uio-ess/bi_dump_chamber/drawings/switch positions - 20895 sketch.pdf

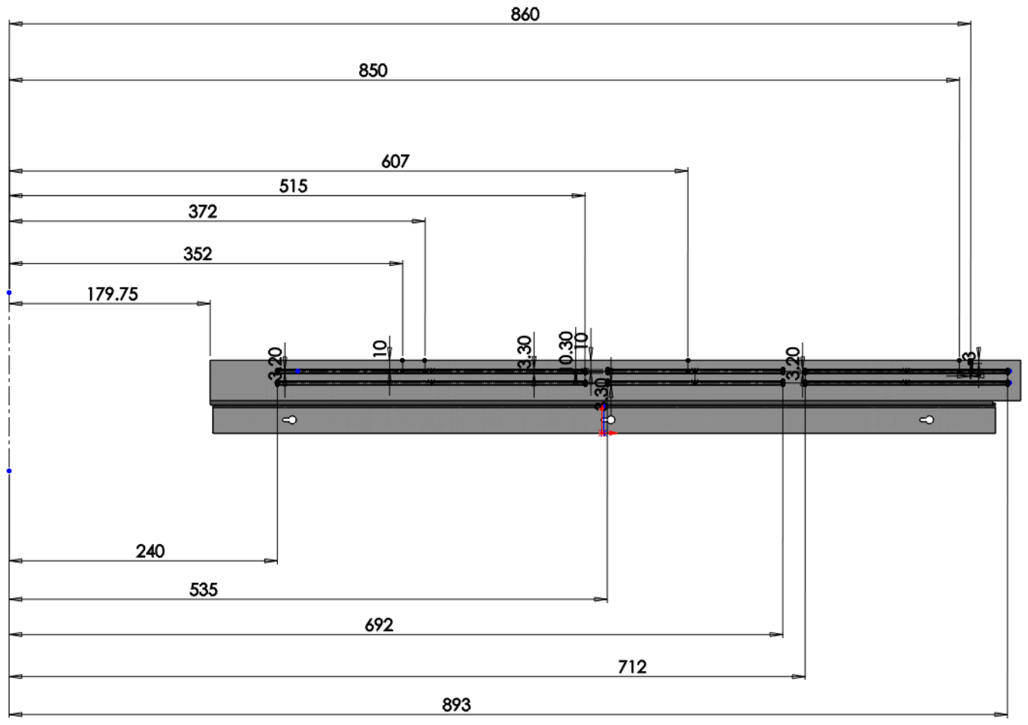
[picture p1: page 1]
