uio-ess/bi_dump_chamber/mirror_mounts/Screenshot from 2020-08-27 12-47-55.png

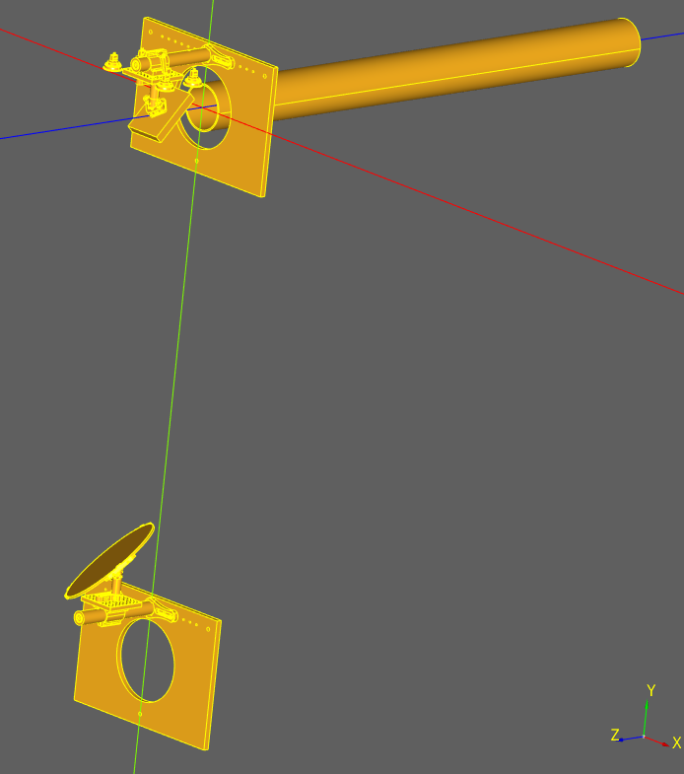
mirror_mounts/Screenshot from 2020-08-27 12-47-55.png
