uio-ess/bi_dump_chamber/screen_holder_assembly/step_output/assembly.step

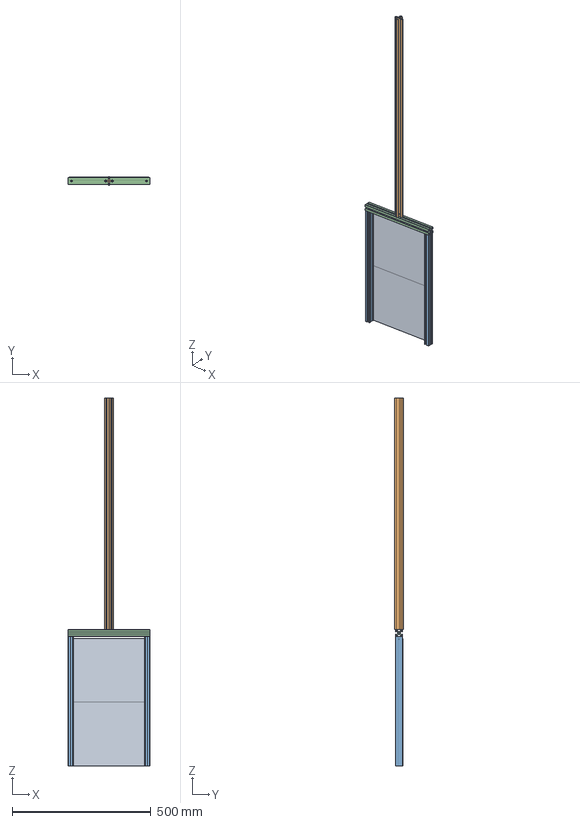
[picture p3: CAD file, 2020-08-26]
screen_holder_assembly/step_output/assembly.step
295.0 x 33.9 x 1327.0 mm
