uio-ess/bi_dump_chamber/mirror_mounts/Mirror_Assembly_M9_B.stp

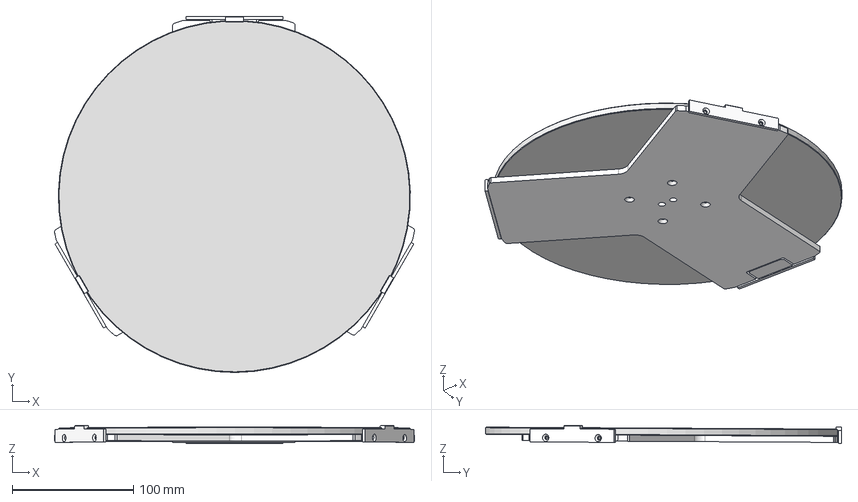
[picture p4: CAD file, 2020-08-27]
mirror_mounts/Mirror_Assembly_M9_B.stp
296.7 x 293.3 x 15.0 mm
Adaptor_Back_Plate_M9_ConceptB
Clamp_M9_C
Dowel_pin003 x 4
Mirror_OD290_t6mm
Clamp_M9_C_low001 x 2
