uio-ess/bi_dump_chamber/mirror_mounts/BA1L_M-Step.step

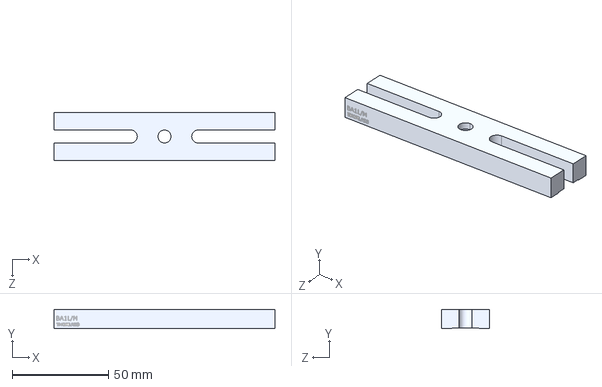
[picture p5: CAD file, 2020-08-28]
mirror_mounts/BA1L_M-Step.step
115.0 x 10.0 x 25.0 mm
