uio-ess/bi_dump_chamber/mirror_mounts/output/pipe.step

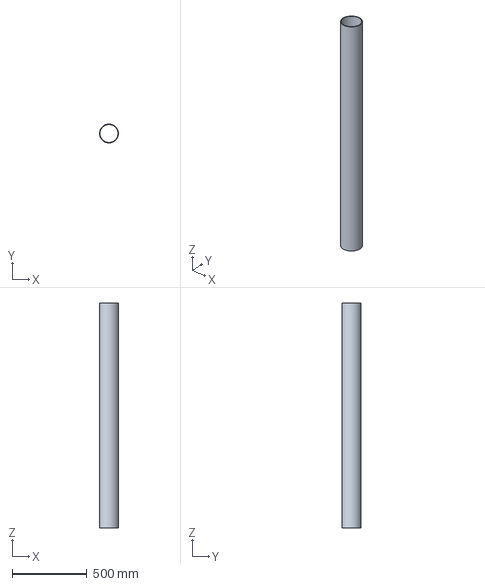
[picture p6: CAD file, 2020-08-28]
mirror_mounts/output/pipe.step
126.9 x 126.9 x 1500.0 mm
