uio-ess/bi_dump_chamber/screen_holder_assembly/step_input/XE25RL2-Step.step

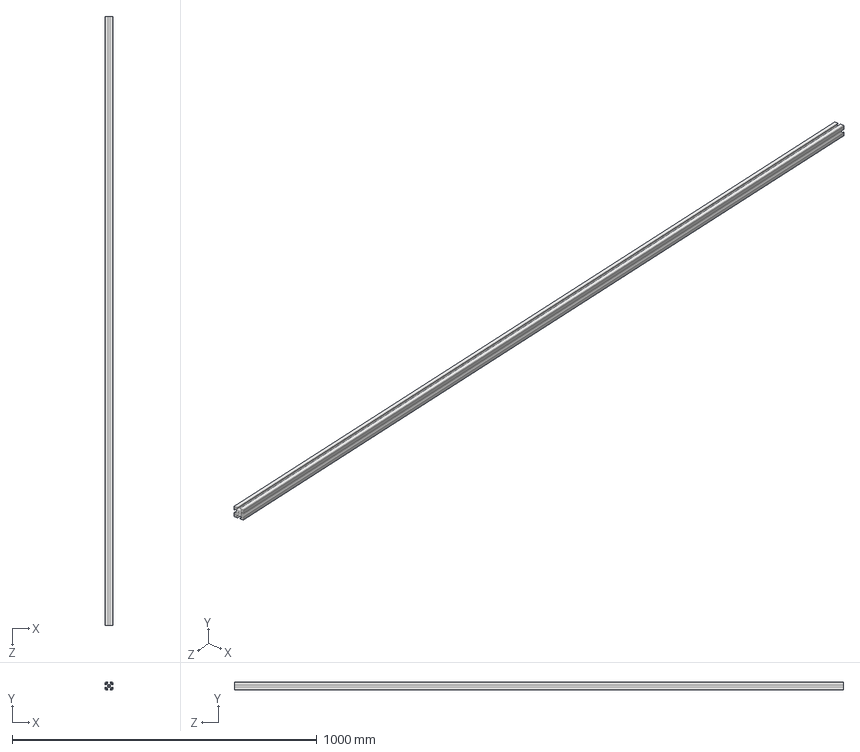
[picture p7: CAD file, 2020-08-26]
screen_holder_assembly/step_input/XE25RL2-Step.step
25.0 x 25.0 x 2000.0 mm
