uio-ess/bi_dump_chamber/frame_holder_piece.step

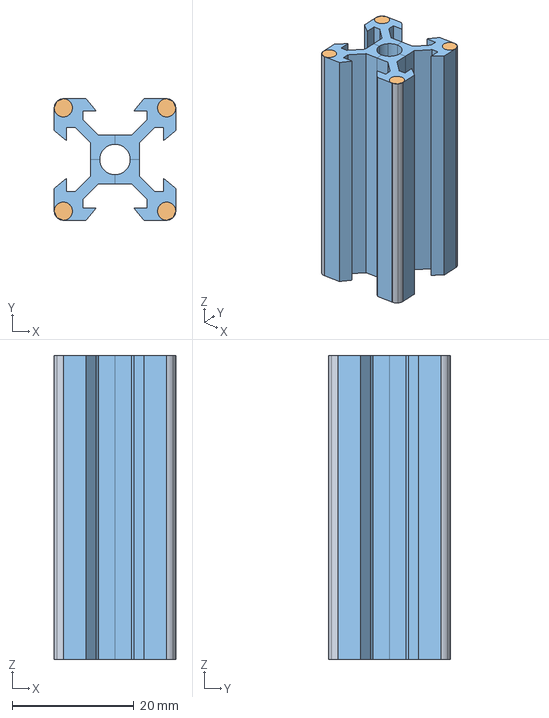
[picture p8: CAD file, 2018-11-07]
frame_holder_piece.step
20.0 x 20.0 x 50.0 mm
