uio-ess/bi_dump_chamber/mirror_mounts/plate_layout.dxf

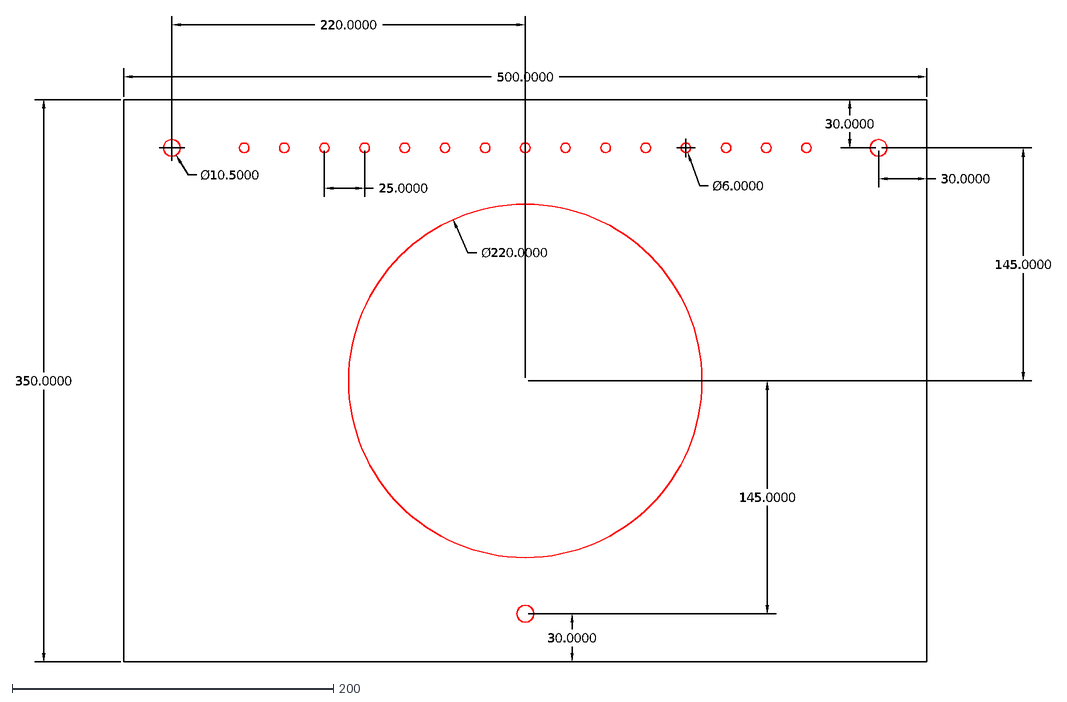
[picture p9: CAD file, 2020-08-27]
mirror_mounts/plate_layout.dxf
350.0000
500.0000
Ø10.5000
Ø220.0000
30.0000
25.0000
Ø6.0000
145.0000
220.0000
