uio-ess/bi_dump_chamber/screen_holder_assembly/step_output/frame_and_screens.step

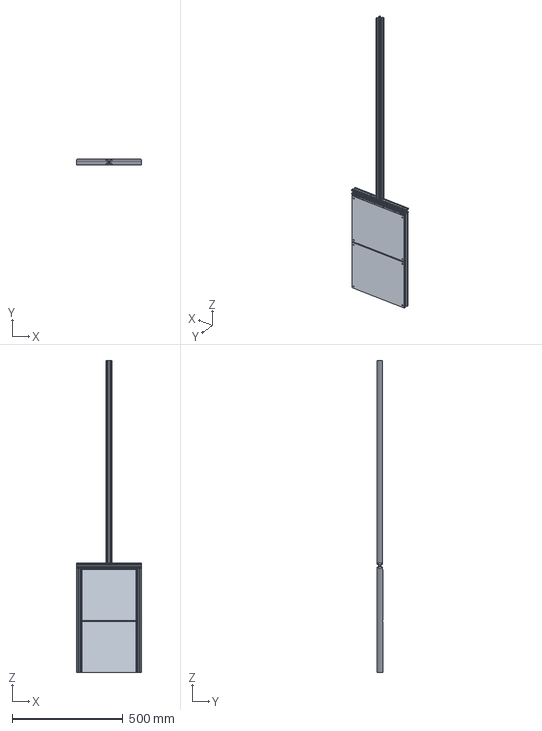
[picture p10: CAD file, 2019-09-20]
screen_holder_assembly/step_output/frame_and_screens.step
295.0 x 26.5 x 1410.0 mm
