uio-ess/bi_dump_chamber/chromux_screens.dxf

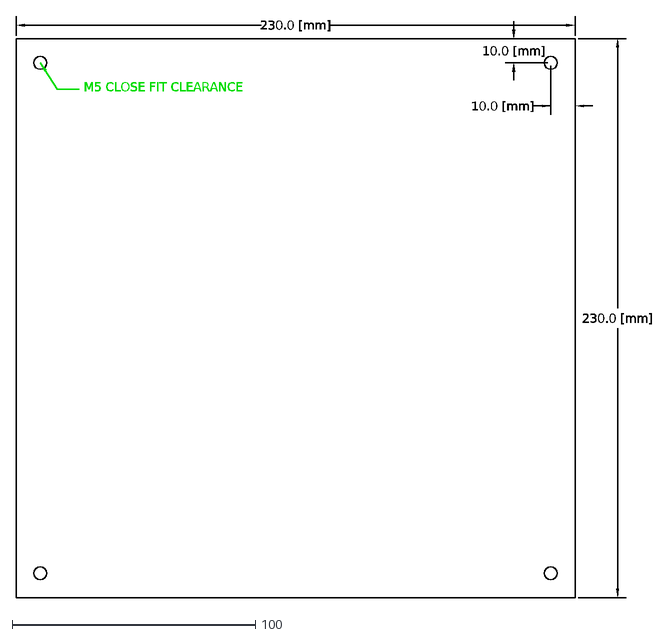
[picture p11: CAD file, 2018-10-30]
chromux_screens.dxf
M5 CLOSE FIT CLEARANCE
230.0 [mm]
10.0 [mm]
