uio-ess/bi_dump_chamber/drawings/bar_cuts_B.dxf

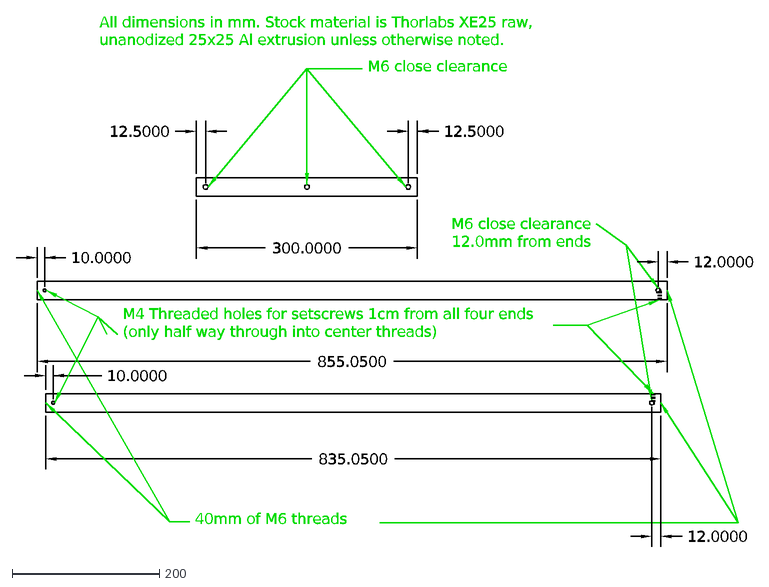
[picture p12: CAD file, 2019-10-22]
drawings/bar_cuts_B.dxf
835.0500
855.0500
300.0000
12.5000
40mm of M6 threads
M6 close clearance
M6 close clearance 12.0mm from ends
10.0000
M4 Threaded holes for setscrews 1cm from all four ends (only half way through into center threads)
12.0000
All dimensions in mm. Stock material is Thorlabs XE25 raw, unanodized 25x25 Al extrusion unless otherwise noted.
