uio-ess/bi_dump_chamber/mirror_mounts/P250_M-Step.step

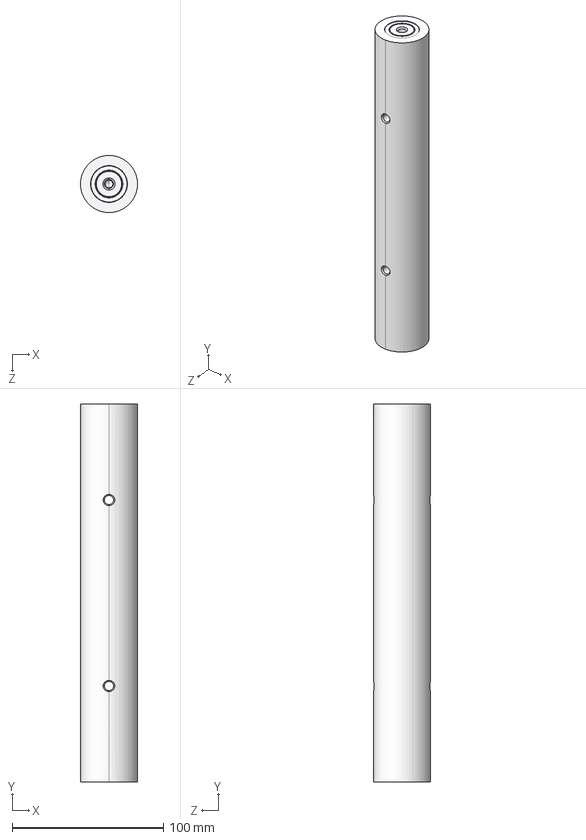
[picture p13: CAD file, 2020-08-27]
mirror_mounts/P250_M-Step.step
37.7 x 250.0 x 37.7 mm
