uio-ess/bi_dump_chamber/drawings/plates.dxf

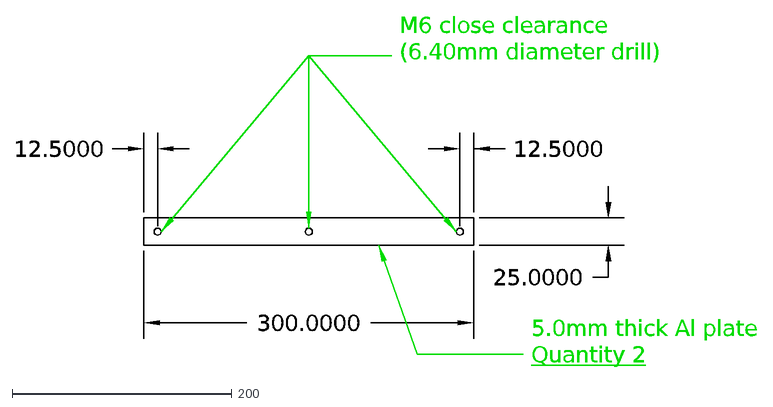
[picture p14: CAD file, 2019-10-11]
drawings/plates.dxf
300.0000
12.5000
M6 close clearance (6.40mm diameter drill)
5.0mm thick Al plate Quantity 2
25.0000
