uio-ess/bi_dump_chamber/mirror_mounts/P75_M-Step.step

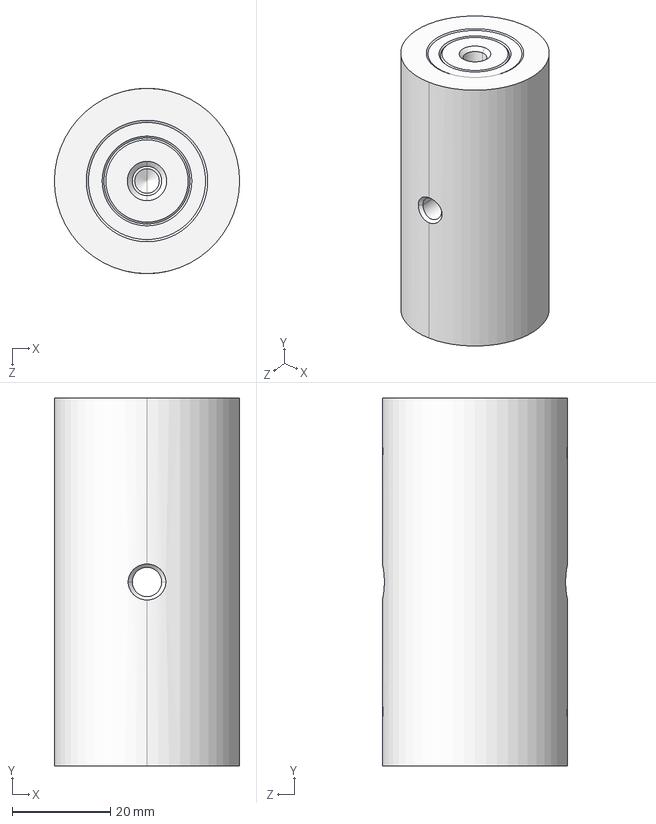
[picture p15: CAD file, 2020-08-27]
mirror_mounts/P75_M-Step.step
37.7 x 75.0 x 37.7 mm
