uio-ess/bi_dump_chamber/mirror_mounts/POLARIS-CA25_M-Step.step

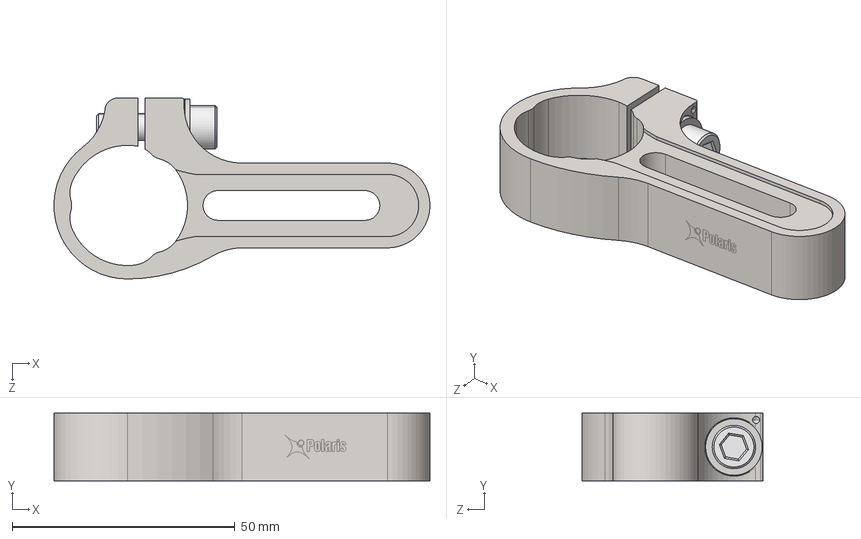
[picture p16: CAD file, 2020-08-27]
mirror_mounts/POLARIS-CA25_M-Step.step
84.4 x 15.2 x 40.6 mm
