uio-ess/bi_dump_chamber/mirror_mounts/C1545_M-Step.step

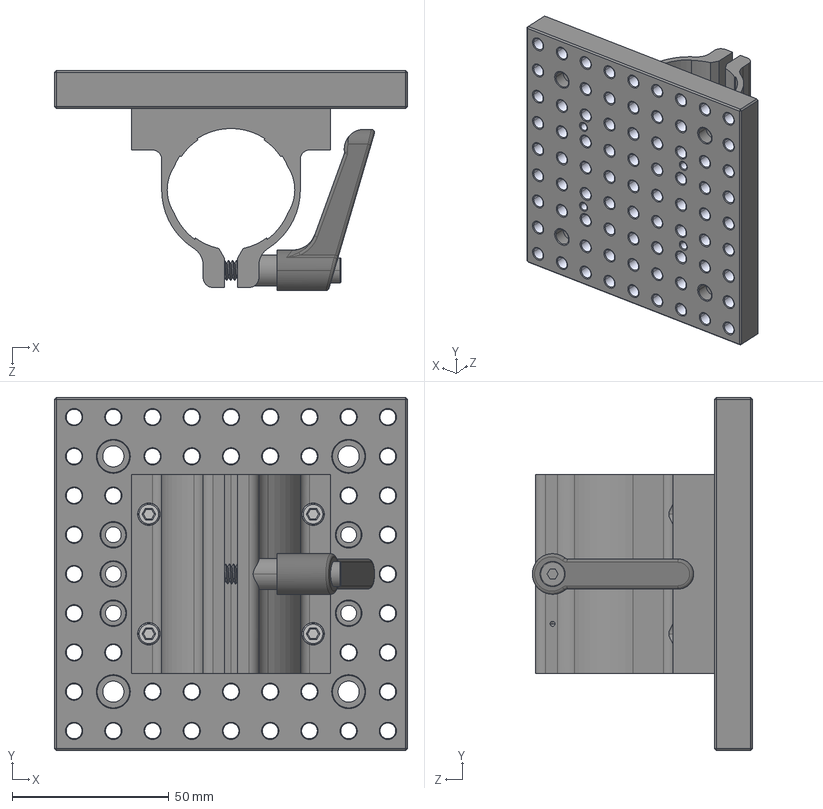
[picture p17: CAD file, 2020-08-27]
mirror_mounts/C1545_M-Step.step
112.5 x 112.5 x 70.2 mm
