uio-ess/bi_dump_chamber/mirror_mounts/P200_M-Step.step

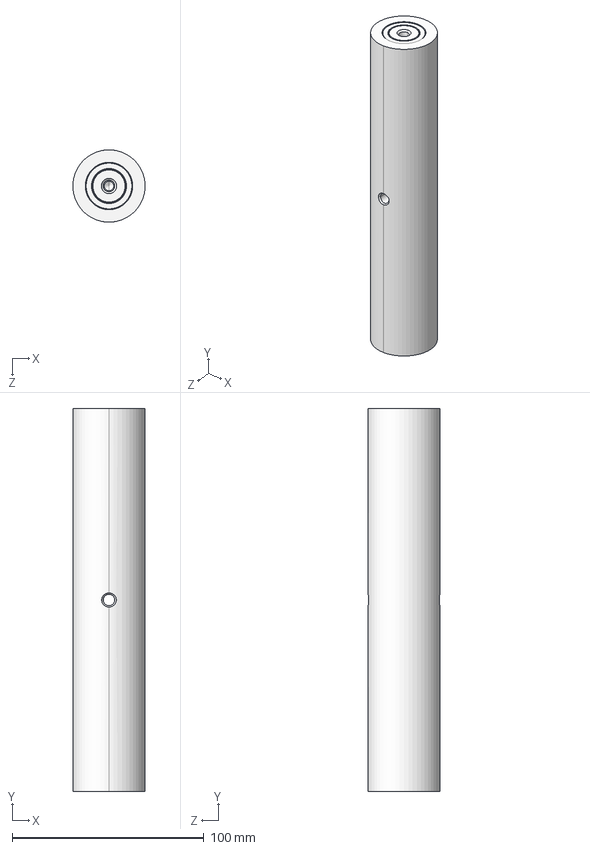
[picture p18: CAD file, 2020-08-26]
mirror_mounts/P200_M-Step.step
37.7 x 200.0 x 37.7 mm
