uio-ess/bi_dump_chamber/mirror_mounts/POLARIS-MA45_M-Step.step

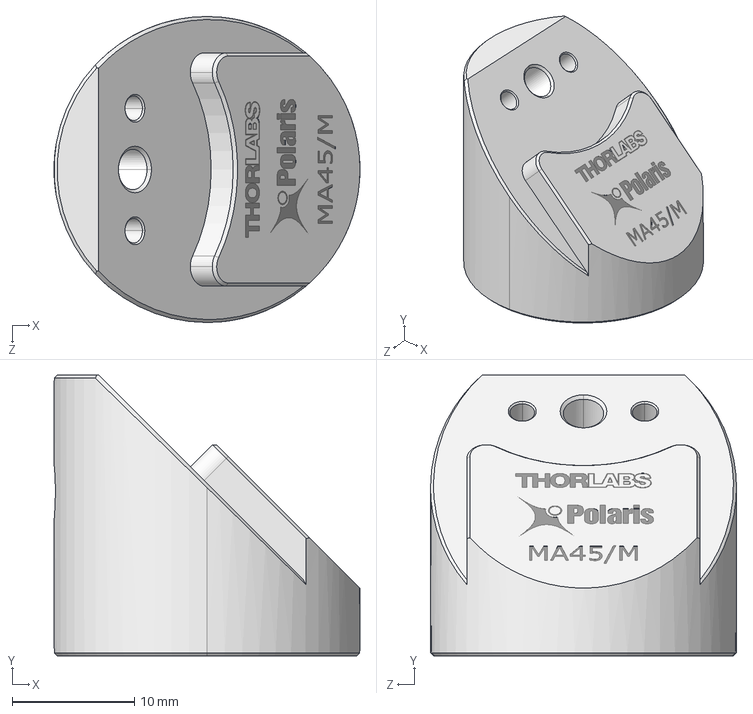
[picture p19: CAD file, 2020-08-26]
mirror_mounts/POLARIS-MA45_M-Step.step
25.0 x 22.9 x 25.0 mm
