uio-ess/bi_dump_chamber/screen_holder_assembly/assembly.scad

// written by grey@christoforo.net

include <al_strut.scad>
//include <threads.scad>

// all dims in mm

screenX = 290;
screenY = 230;
screenT = 1.5;

pipe_inner_diameter = 250;

view_ellipse_Z = 220;
view_ellipse_XY = 306;

spacing_between_screens = 0;

top_bar_spacing = 7;

strut_square = 25;

long_rod_length = 835.05;

draw_threads = false;

//crossbar_width = screenX-2*strut_square;
crossbar_width = 300; // the 5 here is to ensure screen mounting hole alignment
//crossbar_width = screenX-2*strut_square-10-10-25;
echo(crossbar_width);

sidebar_length = spacing_between_screens + 2*screenY + top_bar_spacing;
echo(sidebar_length);

length_of_framing = sidebar_length*2+crossbar_width+long_rod_length;
echo(length_of_framing=length_of_framing);

screen_mount_hole_diameter = 5.8;

//screen_mount_hole_offset = strut_square/2;
screen_mount_hole_offset = 10;

//3cm of m5 threads
//5cm of smooth
// 6cm piece with vent hole at 2cm
module mount_piece(){
    length = 60;
    offset = 30;
    difference(){
        translate([0,0,-offset]) metric_thread (diameter=5, pitch=0.8, length=length);
        cylinder(h=offset,d=2);
        rotate([90,0,0]) cylinder(h=offset,d=2);

    }
}


module view_ellipse(){
        //color([0,1,0]) translate([screenX/2, screenT, screenY/2]) rotate([90, 0 ,0]) scale([view_ellipse_XY, view_ellipse_Z]) circle(d=1);
}

module pipe_view_circle(){
        //#color([0,0,1]) translate([screenX/2, screenT*2, screenY/2]) rotate([90, 0 ,0]) scale([pipe_inner_diameter, pipe_inner_diameter]) circle(d=1);
}

// draws the whole assembly
module assembly(){
    // long "shaft" bar
    rotate([0,0,45]) extrusion_profile_20x20_v_slot_smooth(size=strut_square, height=long_rod_length);
    
    //cross bar
    translate([-crossbar_width/2,0,-strut_square/2]) rotate([0,90,0]) extrusion_profile_20x20_v_slot_smooth(size=strut_square, height=crossbar_width);
    
    //sidebars
    translate([crossbar_width/2-strut_square/2,0,-sidebar_length-strut_square]) extrusion_profile_20x20_v_slot_smooth(size=strut_square, height=sidebar_length);
    translate([-crossbar_width/2+strut_square/2,0,-sidebar_length-strut_square]) extrusion_profile_20x20_v_slot_smooth(size=strut_square, height=sidebar_length);
    
    //%translate([-crossbar_width/2,0,-sidebar_length+strut_square/2]) rotate([0,90,0]) extrusion_profile_20x20_v_slot_smooth(size=strut_square, height=crossbar_width);
    
    //screen1
    translate([-screenX/2,strut_square/2,-screenY-strut_square-top_bar_spacing]){
        //translate ([0,0,-0]) view_ellipse();
        //translate ([0,0,-0]) pipe_view_circle();
        #color([1,1,1]) difference(){
            cube([screenX, screenT, screenY], center=false);
            rotate([90,0,0]) translate ([screen_mount_hole_offset,screen_mount_hole_offset,0]) cylinder(h=screenT*2.2, d=screen_mount_hole_diameter, center=true);
            rotate([90,0,0]) translate ([screenX-screen_mount_hole_offset,screen_mount_hole_offset,0]) cylinder(h=screenT*2.2, d=screen_mount_hole_diameter, center=true);
            rotate([90,0,0]) translate ([screenX-screen_mount_hole_offset,screenY-screen_mount_hole_offset,0]) cylinder(h=screenT*2.2, d=screen_mount_hole_diameter, center=true);
            rotate([90,0,0]) translate ([screen_mount_hole_offset,screenY-screen_mount_hole_offset,0]) cylinder(h=screenT*2.2, d=screen_mount_hole_diameter, center=true);
        }
    }
    
    //screen 2
    translate([-screenX/2,strut_square/2,-2*screenY-strut_square-spacing_between_screens-top_bar_spacing]){
        //view_ellipse();
        //pipe_view_circle();
        #color([1,1,1]) difference(){
            cube([screenX, screenT,screenY], center=false);
            rotate([90,0,0]) translate ([screen_mount_hole_offset,screen_mount_hole_offset,0]) cylinder(h=screenT*2.2, d=screen_mount_hole_diameter, center=true);
            rotate([90,0,0]) translate ([screenX-screen_mount_hole_offset,screen_mount_hole_offset,0]) cylinder(h=screenT*2.2, d=screen_mount_hole_diameter, center=true);
            rotate([90,0,0]) translate ([screenX-screen_mount_hole_offset,screenY-screen_mount_hole_offset,0]) cylinder(h=screenT*2.2, d=screen_mount_hole_diameter, center=true);
            rotate([90,0,0]) translate ([screen_mount_hole_offset,screenY-screen_mount_hole_offset,0]) cylinder(h=screenT*2.2, d=screen_mount_hole_diameter, center=true);
        }
    }
    
    // threaded mount
    if (draw_threads){
        translate([0,0,long_rod_length]) mount_piece();
    }
}

//assembly();
