uio-ess/bi_dump_chamber/screen_holder_assembly/main.scad

include <assembly.scad>

assembly();
