uio-ess/bi_dump_chamber/simple_mockup/main.scad

include <chamber_mockup.scad>

// downstream chamber
drawChamber();

//translate ([-600,0,0]) translate ([400,0,0]) drawChamber(); 

//translate ([-1500,0,0]) drawChamber(); 

//translate ([-600,0,0]) drawChamber(); 

// upstream chamber
//translate ([-400,0,0]) drawChamber(upstreamPipeL=200, downstreamPipeL=400, viewPortZAngle=-45); // downstream chamber
