uio-ess/bi_dump_chamber/vis/main.scad

// written by grey@christoforo.net
// movies generated like this;
//time = 0
//steps = 500
//FPS = 100
// ffmpeg -framerate 30 -pattern_type glob -i '*.png' -vf "pad=ceil(iw/2)*2:ceil(ih/2)*2" -c:v libx264 -pix_fmt yuv420p out2.mp4
include <../screen_holder_assembly/assembly.scad>
include <../simple_mockup/chamber_mockup.scad>

vessel_cross_center_to_actuator_bottom_flange = 682.45;

act_flange_D = 114;
$fn=50;
// switch positions
LT_pos=500;
SA_pos=780.00;
SB_pos=612.55;
SC_pos=330;
LB_pos=300;


// draws the stuff that will move as a funciton of actuator flange spacing
module things_that_move(mover_position){
    translate([0,0,vessel_cross_center_to_actuator_bottom_flange+mover_position]) circle(d=act_flange_D);
    rotate([0,0,90]) translate([0,0,-long_rod_length+vessel_cross_center_to_actuator_bottom_flange+mover_position]) assembly();
}

// animation
min_actuator_position = SC_pos;
max_actuator_position = SA_pos;
t = 2*abs($t-0.5);
actuator_position = SC_pos + t*(max_actuator_position-min_actuator_position);
things_that_move (actuator_position);

// at top limit switch (should never be here, but this should be safe)
//things_that_move (LT_pos);

// at screen withdrawn position switch
//things_that_move (SA_pos);

// at bottom screen position switch
//things_that_move (SB_pos);

// at top screen position switch
things_that_move (SC_pos);

// at bottom limit switch (should never be here, but this should be safe)
//things_that_move (LB_pos);

// draw chamber mockup
%drawChamber();

// mouning actuator flange (stationary)
translate([0,0,vessel_cross_center_to_actuator_bottom_flange]) circle(d=act_flange_D);
