uio-ess/bi_dump_chamber/(list of files, cad)

Other CAD files:
2d_screen_vis.dxf
drawings/nuts.dxf
simpleMockup/bi_dump_chamber.scad
old/289-10962_Tuning_Dump_Chamber.stp
old/UHV_HLSML64300SS0/Actuator with Rod.FCStd
old/justPipes.fcstd
old/justPipes.stp
old/topDownSection.dxf
old/viewFromDumpSection.dxf
screen_holder_assembly/threads.scad
