uio-ess/bi_dump_chamber/screen_holder_assembly/step_input/README.md

extrusion step file retrieved from https://www.thorlabs.com/_sd.cfm?fileName=3167-E0W.step&partNumber=XE25RL2
