uio-ess/bi_dump_chamber/screen_holder_assembly/frame00048.png

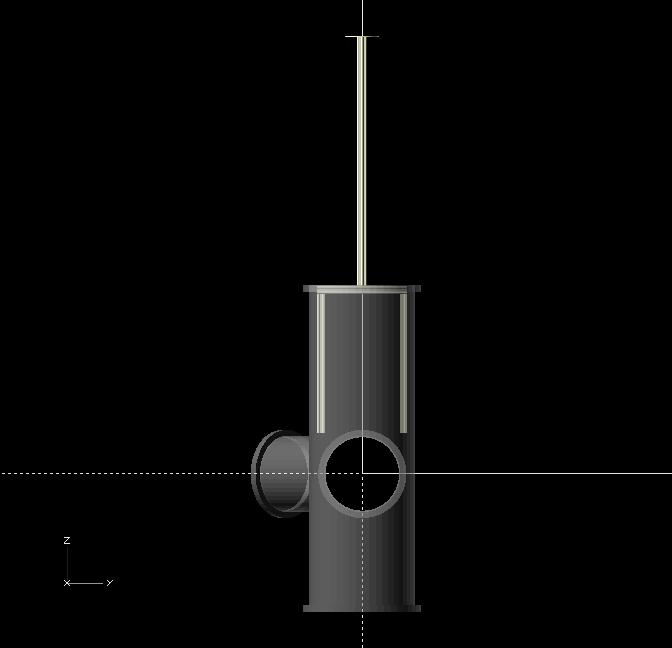
screen_holder_assembly/frame00048.png
