uio-ess/bi_dump_chamber/drawings/nuts.pdf

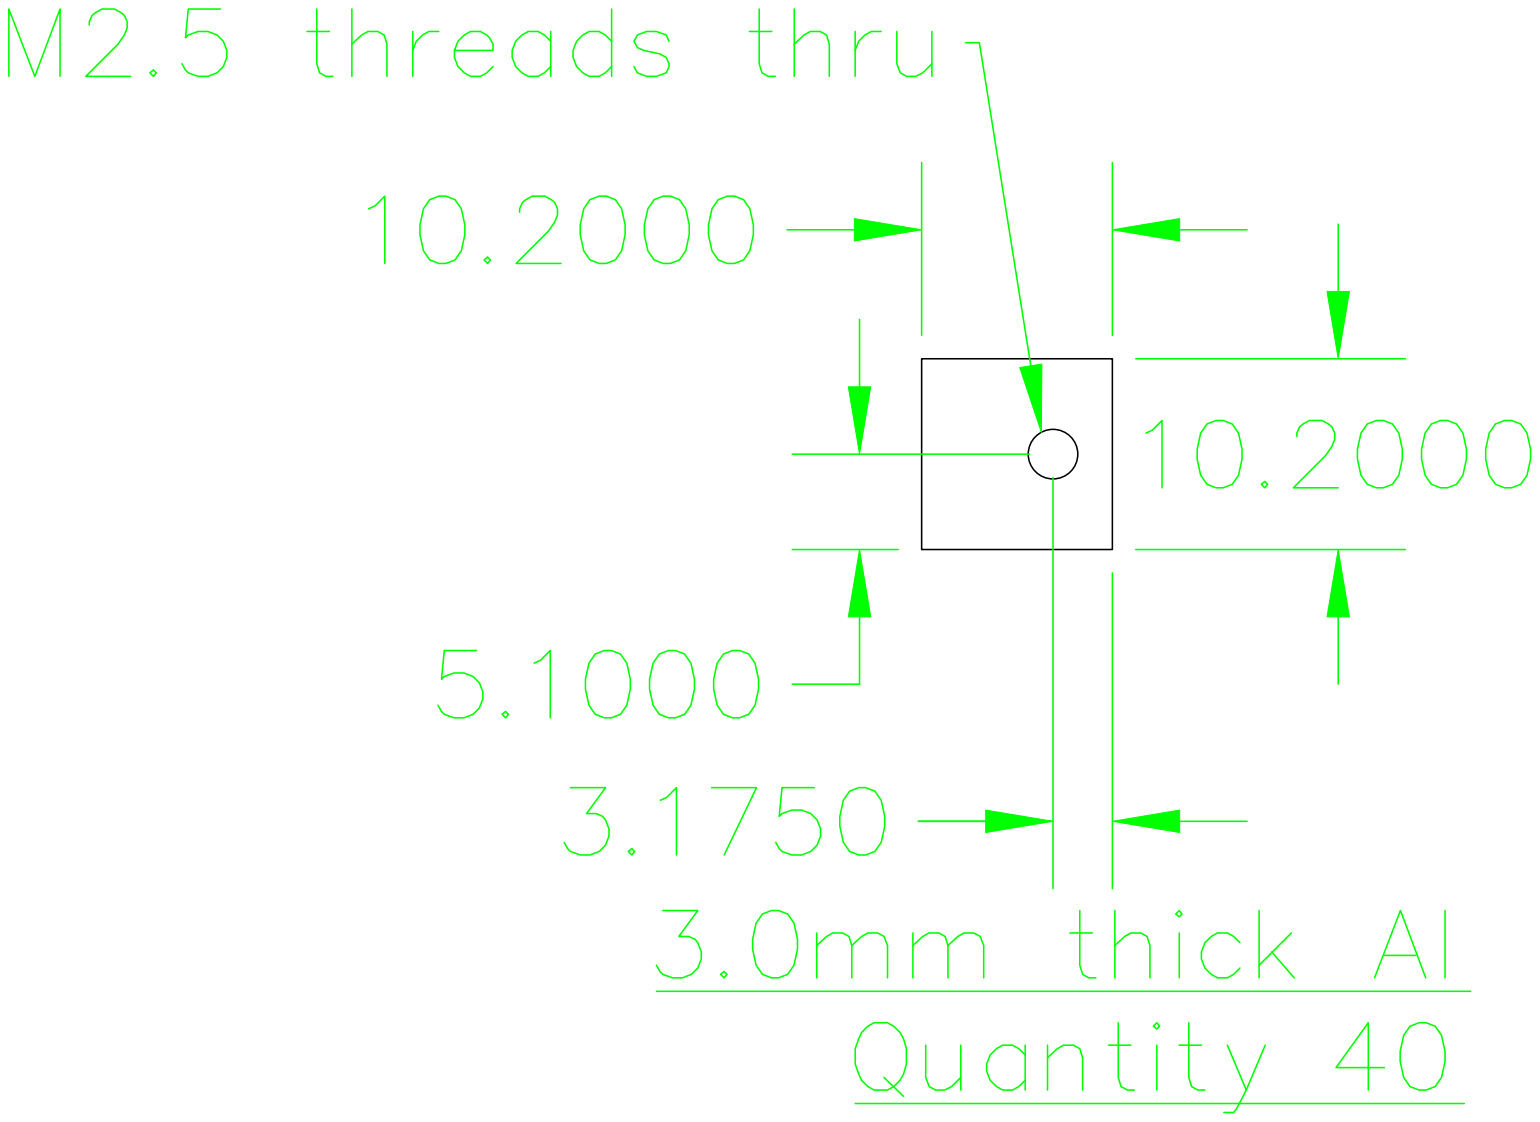
[picture p43: page 1]
