uio-ess/bi_dump_chamber/drawings/bar_cuts_A.pdf

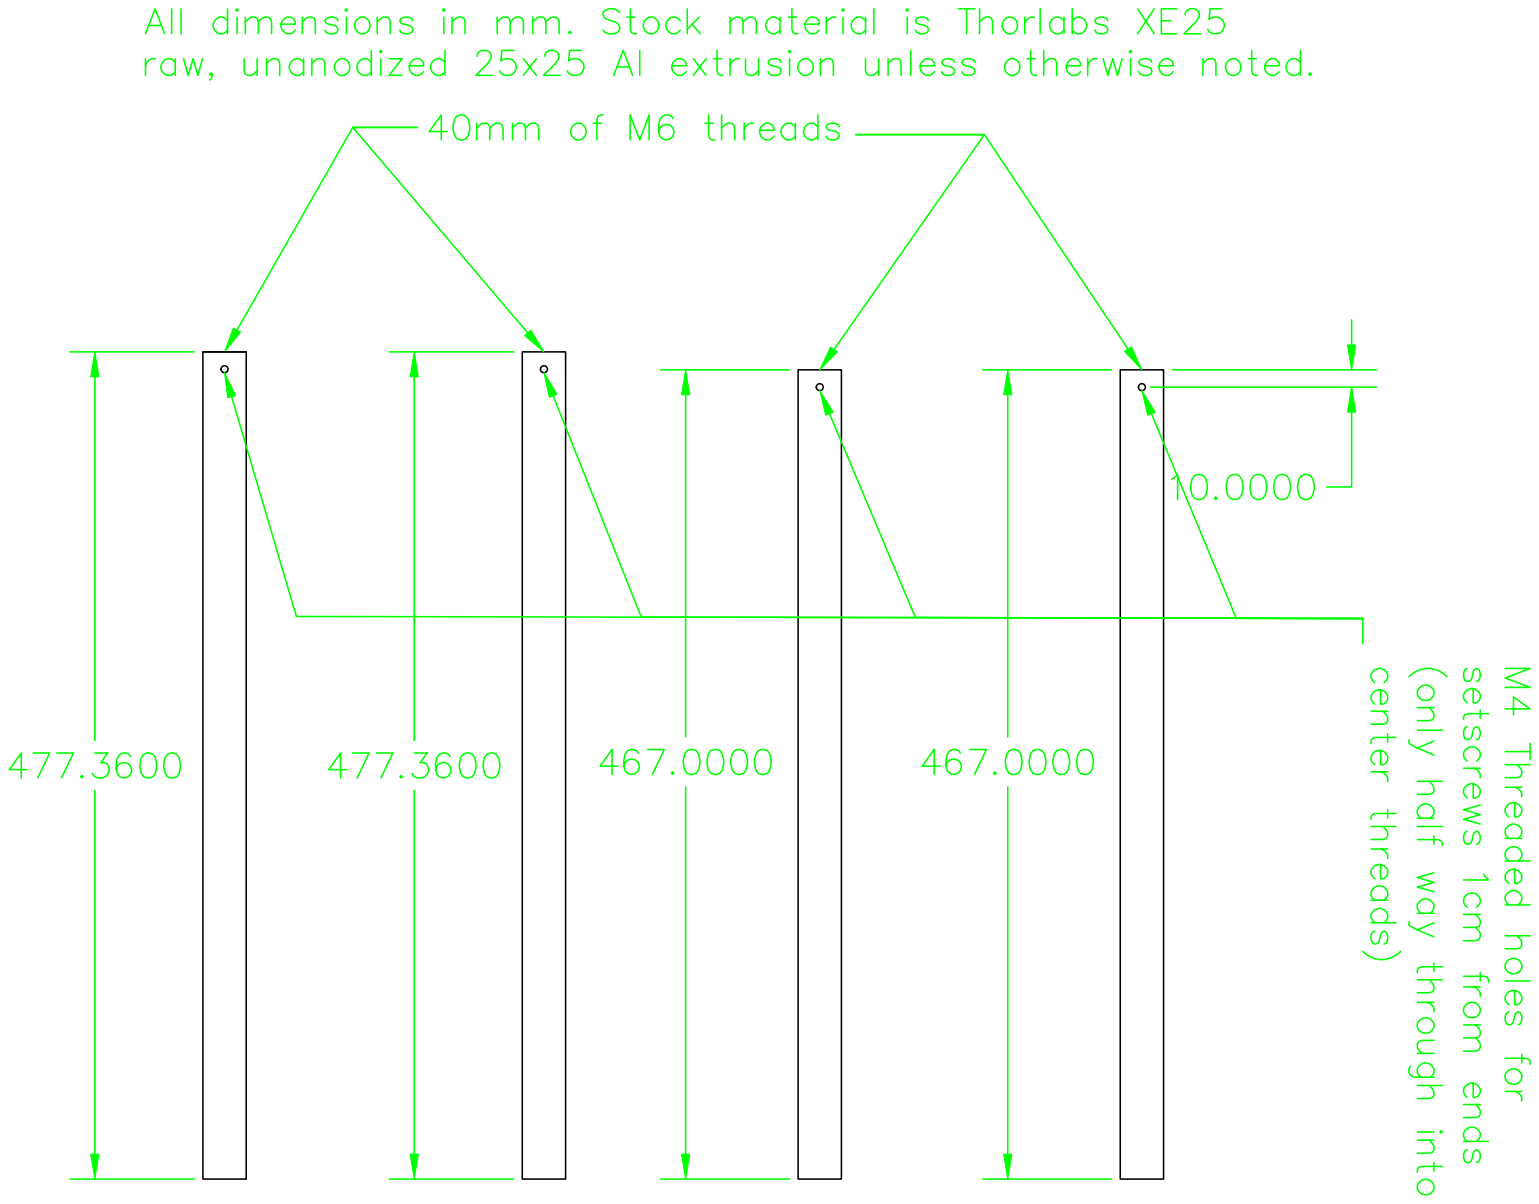
[picture p44: page 1]
