uio-ess/bi_dump_chamber/drawings/bar_cuts_B.pdf

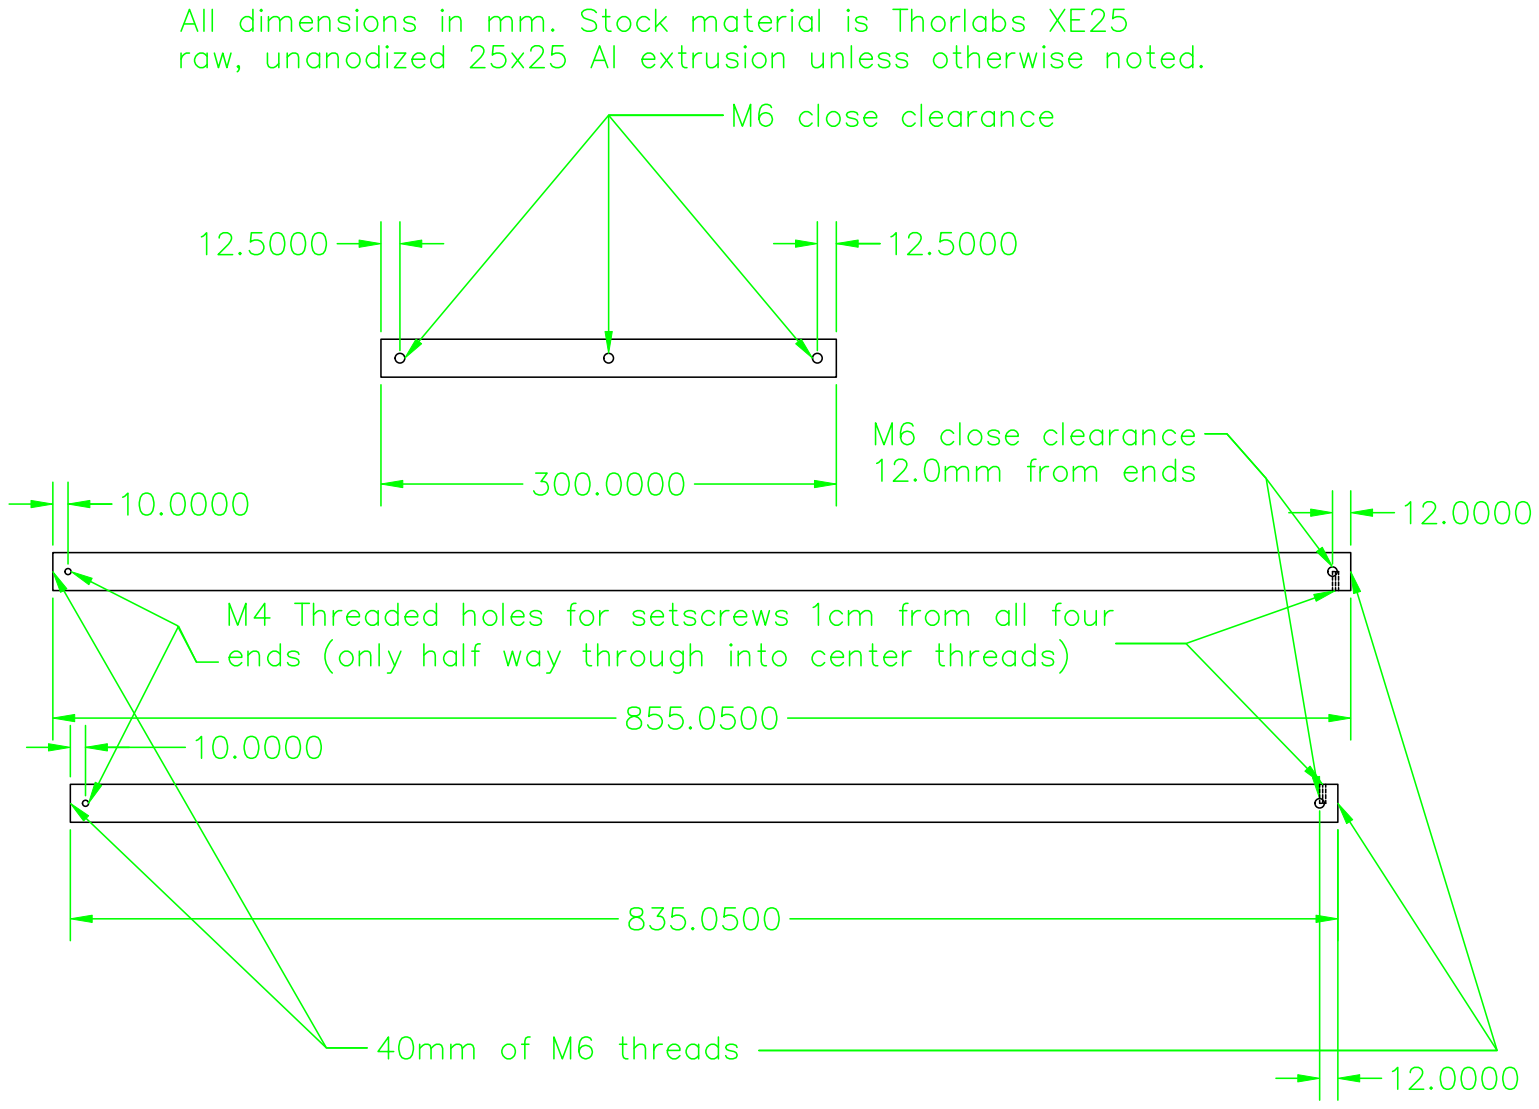
[picture p45: page 1]
