uio-ess/bi_dump_chamber/drawings/plates.pdf

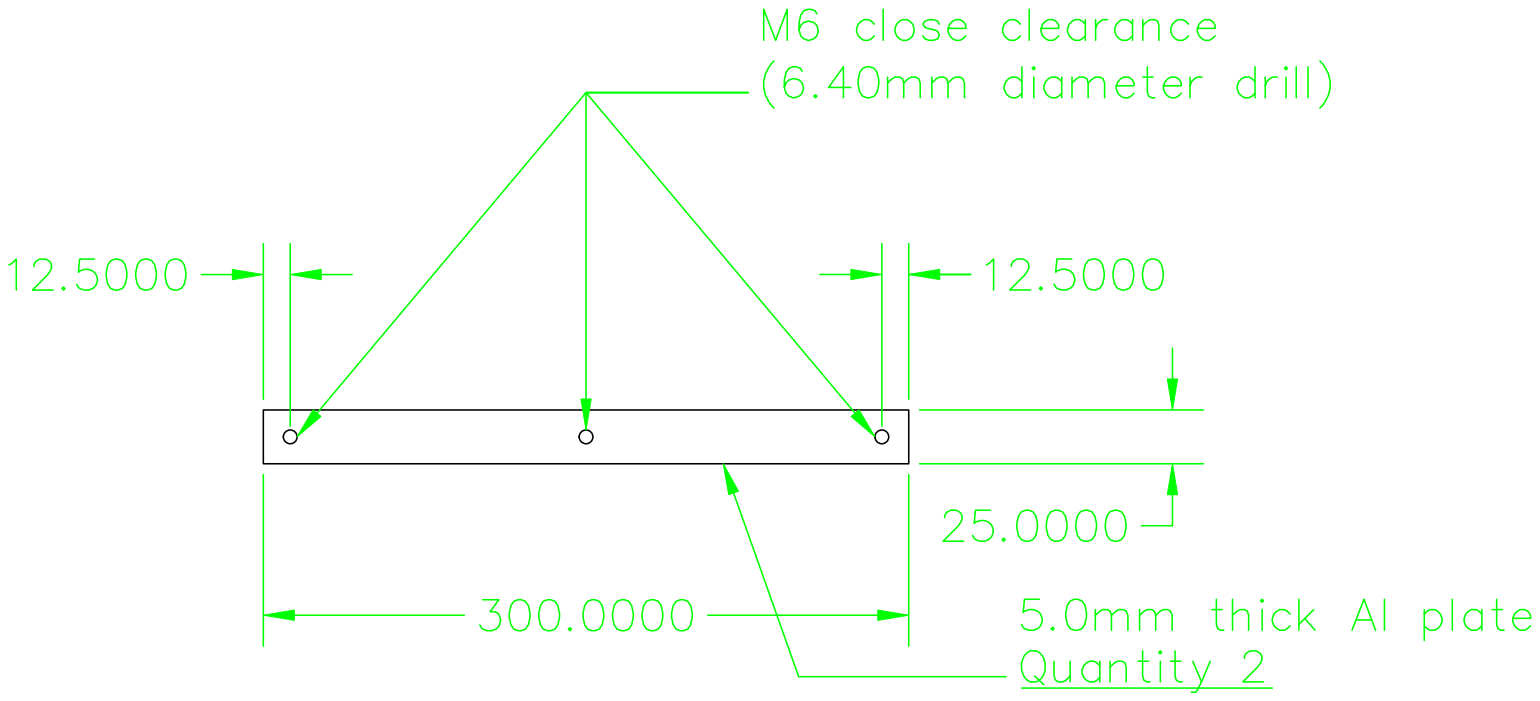
[picture p46: page 1]
