uio-ess/bi_dump_chamber/doc/for_chess/SF133210_B 83160154.pdf

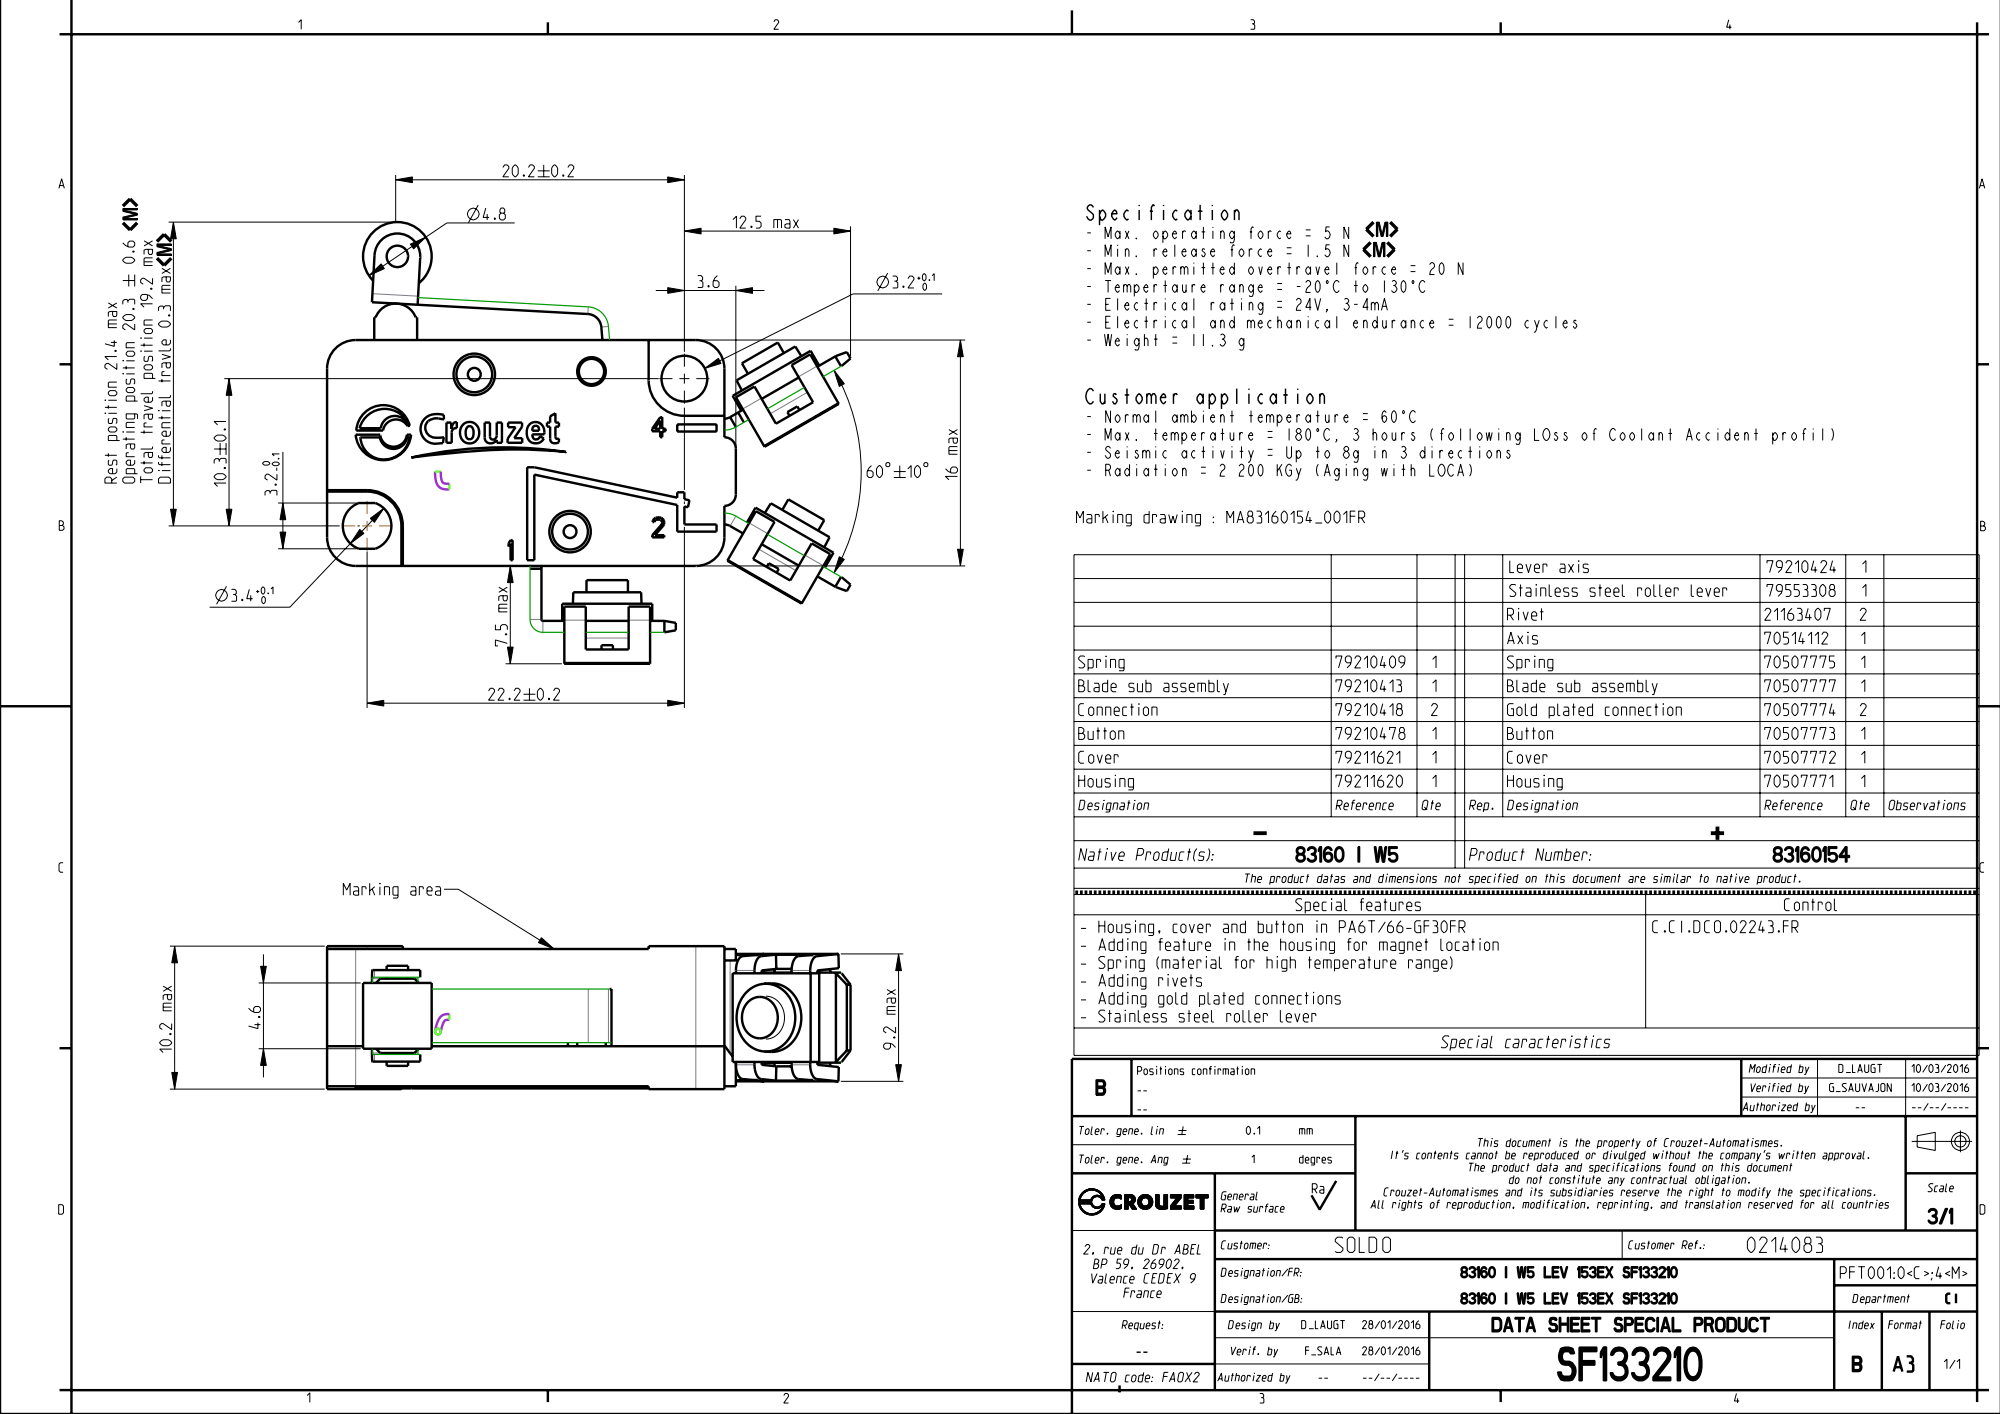
[picture p47: page 1]
