uio-ess/bi_dump_chamber/(commit log)

2018-04-26 add old dump files
    [289-10962_Tuning_Dump_Chamber.stp, Actuator with Rod.FCStd, justPipes.fcstd, justPipes.stp, topDownSection.dxf, viewFromDumpSection.dxf]
2018-04-26 update top-down view of old chamber
    [topDownSection.dxf]
2018-10-09 new chamber master CAD and screen holder frame design
    [al_strut.scad, bi_dump_chamber.scad, bi_dump_chamber.step, everynut.scad, fastener_info.xlsx, main.scad, threads.scad]
2018-10-23 move to 230x230mm screens
    [main.scad]
2018-10-23 calcualte limit switch positions
    [main.scad]
2018-10-30 add screen drawings
    [chromux_screens.dxf]
2018-10-30 fix dimension scale of chromux drawing
    [chromux_screens.dxf]
2018-11-02 change screen thickness to 1mm, generate step output
    [frame_and_screens.step, main.scad]
2018-11-03 fix for incomplete screen removal at SA
    [frame_and_screens.step, main.scad]
2018-11-05 clean up sketch
    [bi_dump_chamber.scad]
2018-11-05 update LT to be all the way at 860mm
2018-11-06 work on screen motion visualization
    [assembly.scad, bi_dump_chamber.step, chamber_mockup.scad, everynut.scad, fastener_info.xlsx, main.scad, threads.scad]
2018-11-06 make some movies
    [main.scad]
2018-11-06 improve movies
    [assembly.scad, main.scad]
2018-11-07 make the vertical tube bigger and change the angle of the screens to be normal to beam direction
    [al_strut.scad, assembly.scad, chamber_mockup.scad, frame_and_screens.step, frame_holder_piece.step, main.scad, threads.scad]
2018-11-21 add fancy mount piece
    [assembly.scad, main.scad]
2018-11-21 new output vids
    [main.scad]
2018-11-21 put connector into assembly
    [assembly.scad, main.scad]
2018-11-21 add approximation for view area
    [assembly.scad, main.scad]
2018-12-04 update chamber cad
2018-12-04 change mount piece to all threads
    [assembly.scad]
2019-09-20 ichange profile to 25x25, widen horizonal bar, fix screen dims, regenerate steps
    [al_strut.scad, assembly.scad, frame_and_screens.step]
2019-09-20 only draw assembly in main
    [assembly.scad]
2019-09-25 move top limit switch position by 3mm and rotate log bar by 45 deg
    [assembly.scad, main.scad]
2019-09-25 wip on limit switches
    [assembly.scad, main.scad]
2019-10-03 wip on final switch positions
2019-10-08 updade step from danish, add 2d screen pos drawing, update movement calcs
    [2d_screen_vis.dxf]
2019-10-08 update movement calcs
    [2d_screen_vis.dxf]
2019-10-11 going to manufacturing
    [assembly.scad, bar_cuts.dxf, bar_cuts_B.dxf, plates.dxf]
2019-10-11 added setscrews to sidebars
    [bar_cuts.dxf]
2019-10-22 add missin dim to bar cut drawings
    [bar_cuts.dxf, bar_cuts_B.dxf]
2019-11-12 add nut and update chamber cad
    [nuts.dxf]
2020-04-28 draw a proper assembly step for the screen holder with cadquery
    [XE25RL2-Step.step, assembly.scad, assembly.step, main.scad]
2020-05-05 make building better
    [assembly.step]
2020-08-26 add chess docs, mirror mount 3d model in progress, mods for new movies
    [1001.dxf, MC 12x31.dxf, P200_M-Step.step, PB4_M-Step.step, PF175B-Step.step, POLARIS-MA45_M-Step.step, assembly.scad, chamber_mockup.scad]
2020-08-27 mirror mount revision done
    [1001.dxf, C1545_M-Step.step, MC 12x31.dxf, Mirror_Assembly_M9_B.stp, POLARIS-CA25_M-Step.step, cross.dxf, cross2.dxf, gear.dxf]
2020-08-27 snapshot of wip
    [P250_M-Step.step, P75_M-Step.step, topplate.step]
2020-08-27 post meeting
    [g.step, plate_layout.dxf, topplate.step]
2020-08-28 rename some files and export with proper names
    [C1545_M-Step.step, Mirror_Assembly_M9_B.stp, P200_M-Step.step, P250_M-Step.step, P75_M-Step.step, PB4_M-Step.step, PF175B-Step.step, POLARIS-CA25_M-Step.step]
