uio-ess/bi_dump_chamber/drawings/bar_cuts.dxf

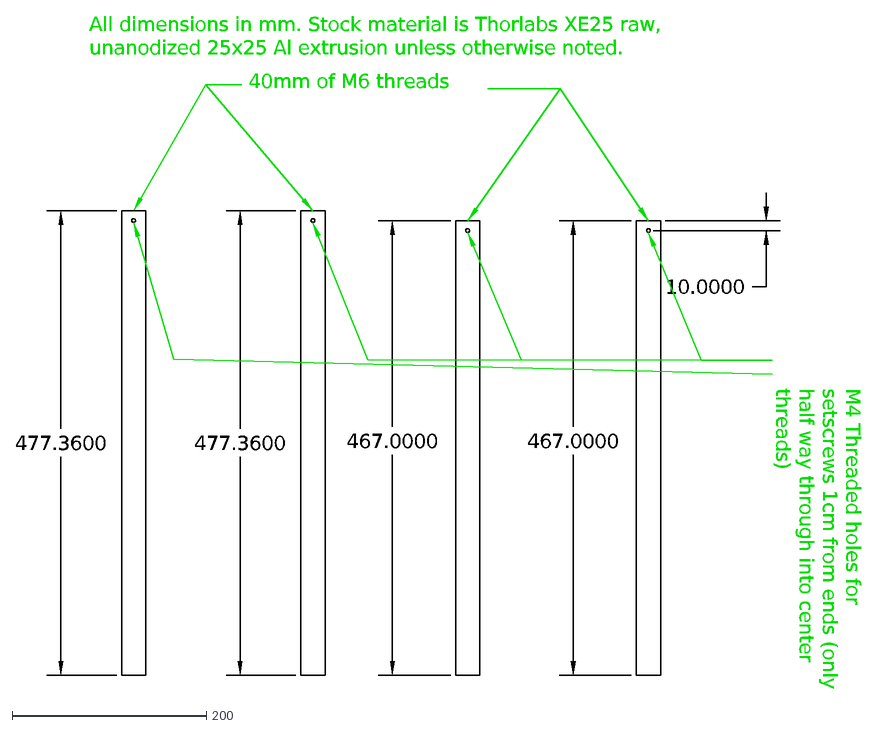
[picture p1: CAD file, 2019-10-22]
drawings/bar_cuts.dxf
477.3600
467.0000
40mm of M6 threads
10.0000
M4 Threaded holes for setscrews 1cm from ends (only half way through into center threads)
All dimensions in mm. Stock material is Thorlabs XE25 raw, unanodized 25x25 Al extrusion unless otherwise noted.
